mpinnuck/GarageDoorController/Housing/GarageDoorController.FCStd

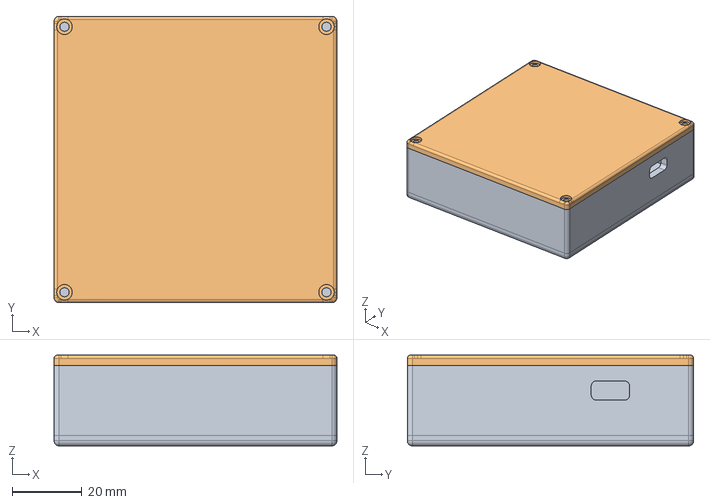
[picture p1: CAD file, 2026-11-12]
Housing/GarageDoorController.FCStd
81.0 x 82.0 x 26.0 mm
Base
Lid
