mpinnuck/GarageDoorController/Housing/stl/Base.stl

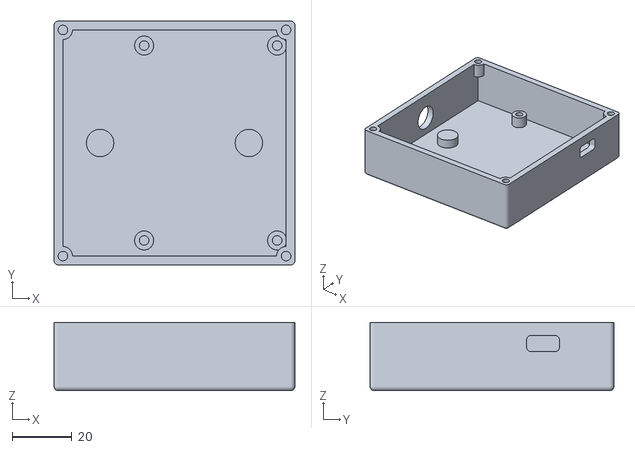
[picture p2: CAD file, 2026-11-12]
Housing/stl/Base.stl
81.0 x 82.0 x 23.0
