mpinnuck/GarageDoorController/Housing/stl/Lid.stl

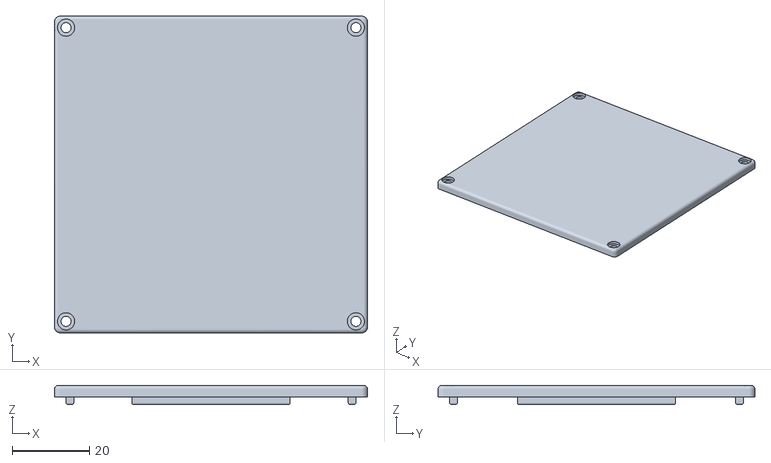
[picture p3: CAD file, 2026-11-12]
Housing/stl/Lid.stl
81.0 x 82.0 x 5.00
