mpinnuck/GarageDoorController/Housing/stl/Washer.stl

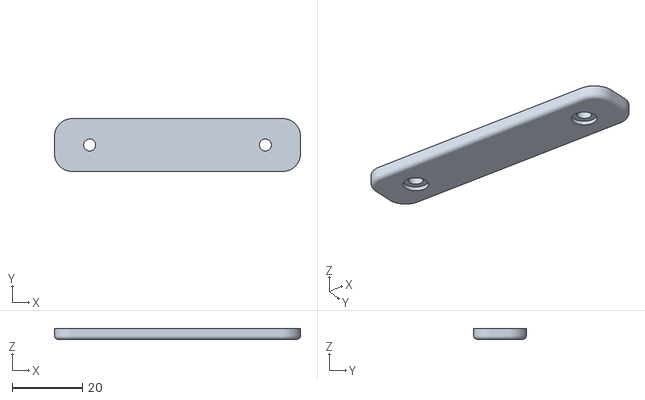
[picture p4: CAD file, 2026-10-28]
Housing/stl/Washer.stl
70.0 x 15.0 x 3.00
