mpinnuck/GarageDoorController/Circuit/GarageDoorController/GarageDoorController.kicad_pcb

## KiCad design Circuit/GarageDoorController/GarageDoorController.kicad_pcb (2026-11-12)

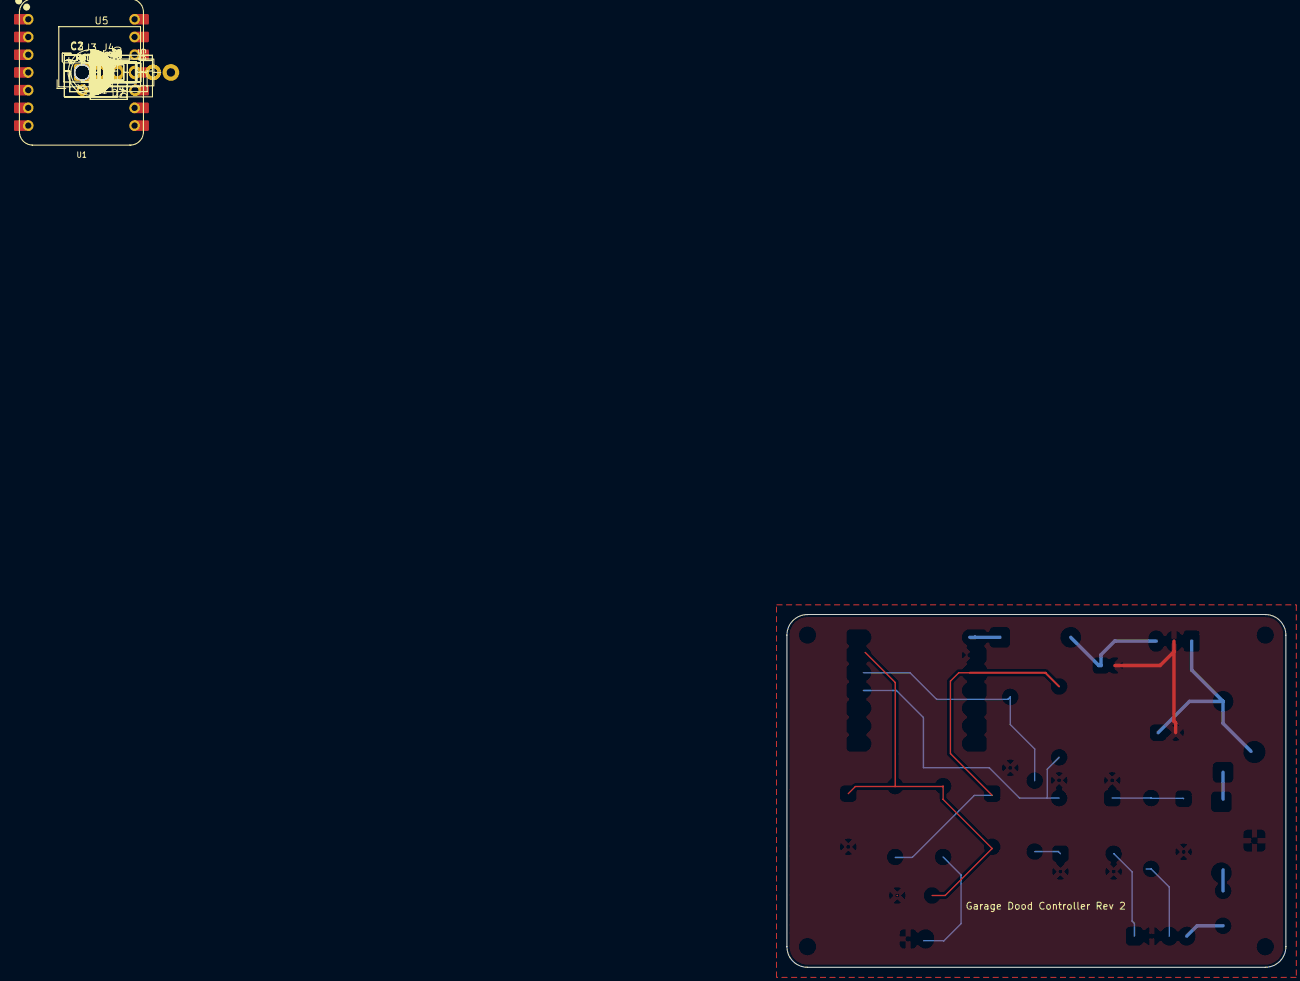
[picture p5: board GarageDoorController.kicad_pcb from above]

Board: 2 copper layers, 71.5 x 50.6 mm, 23 parts (0 on the bottom side), 16 nets.

Parts:
C1: 100nF; C_Disc_D10.0mm_W2.5mm_P5.00mm
C2: 10uF 50V; CP_Radial_D6.3mm_P2.50mm
C3: 22uF 16V; CP_Radial_D5.0mm_P2.00mm
D2, D3, D4: 1N4148; D_DO-35_SOD27_P7.62mm_Horizontal
D5: 1N4007; D_DO-41_SOD81_P10.16mm_Horizontal
D6: P6KE30CA; D_DO-15_P12.70mm_Horizontal
D7: 1N5819; D_DO-41_SOD81_P10.16mm_Horizontal
D8: 1N4740A 10V 1W; D_DO-41_SOD81_P10.16mm_Horizontal
F1: MF-R020 0.2A; C_Disc_D5.0mm_W2.5mm_P5.00mm
J3: JST PH 2-pin; JST_XH_B2B-XH-A_1x02_P2.50mm_Vertical
J4: JST PH 4-pin; JST_XH_B4B-XH-A_1x04_P2.50mm_Vertical
R1, R9: 10k; R_Axial_DIN0207_L6.3mm_D2.5mm_P10.16mm_Horizontal
R6: 1k; R_Axial_DIN0207_L6.3mm_D2.5mm_P10.16mm_Horizontal
R7: 330R; R_Axial_DIN0207_L6.3mm_D2.5mm_P10.16mm_Horizontal
R8: 4k7 1/4W; R_Axial_DIN0207_L6.3mm_D2.5mm_P10.16mm_Horizontal
R10: 100k; R_Axial_DIN0207_L6.3mm_D2.5mm_P10.16mm_Horizontal
U1: XIAO-ESP32-C3-DIP; XIAO-ESP32C3-DIP
U3: TLP222A; DIP-4_W7.62mm
U4: PC817; DIP-4_W7.62mm
U5: R-78E5.0-0.5; Converter_DCDC_RECOM_R-78E-0.5_THT

Connections:
+3V3: D2.1 (K), R1.1, R9.1, U1.12 (VCC_3V3)
/Opener control/LAMP: J4.3, R8.2
/Opener control/OPENER_24V: F1.1, J4.4
/Opener control/PB: J4.1, U3.4
GND: C1.2, C2.2, C3.2, D3.2 (A), D4.2 (A), D6.1 (A1), J3.1, J4.2, R10.2, U1.13 (GND), U3.2, U3.3, U4.2, U4.3, U5.2 (GND)
unnamed: C1.1, D2.2 (A), D3.1 (K), R1.2, R6.2, U1.2 (GPIO3/A1/D1)
unnamed: D4.1 (K), R8.1, U4.1
unnamed: D5.2 (A), F1.2
unnamed: D5.1 (K), D8.1 (K)
unnamed: C2.1, D6.2 (A2), D8.2 (A), U5.1 (IN)
unnamed: C3.1, D7.2 (A), U5.3 (OUT)
unnamed: J3.2, R6.1
unnamed: R7.2, U3.1
OPENER_MOVING: R9.2, U1.4 (GPIO5/A3/D3), U4.4
OPENER_TRIG: R7.1, R10.1, U1.3 (GPIO4/A2/D2)
XIAO_5V: D7.1 (K), U1.14 (VBUS)
