mpinnuck/GarageDoorController/(commit log)

2026-10-26 Claude initial layout
    [GarageDoorController.kicad_pcb, GarageDoorController.kicad_sch, opener-control.kicad_sch]
2026-10-27 Rev 1 PCB: routed board and fab files
    - 2-layer, 71.5 x 50.6 mm, rounded corners, four M2 mounting holes,
    GND pours both layers
    - Opener parts placed and routed: 24 V input chain (J4, F1, D5, D8,
    C2/D6, U5 R-78E, C3/D7 to XIAO 5 V), U3 TLP222A on PB, U4 PC817 on FLASH
    - Power path 0.5 mm; direct F.Cu ground returns U5 to C2/C3
    - DRC: 0 errors, 0 unconnected, 19 cosmetic warnings (DRC.rpt)
    - Gerbers and drill files in gerbers/, zipped for the fab
    - Ignore .DS_Store
    Claude-Session: https://claude.ai/code/session_01BUyReJ4iEoMZE9spF9mEyw
    [GarageDoorController-B_Cu.gbl, GarageDoorController-B_Mask.gbs, GarageDoorController-B_Paste.gbp, GarageDoorController-B_Silkscreen.gbo, GarageDoorController-Edge_Cuts.gm1, GarageDoorController-F_Cu.gtl, GarageDoorController-F_Mask.gts, GarageDoorController-F_Paste.gtp]
2026-10-28 Rev 2 PCB all references to FLASH changed LAMP + Controller housing
    [Base.stl, GarageDoorController.FCStd, GarageDoorController.kicad_pcb, Lid.stl, Washer.stl, opener-control.kicad_sch]
2026-11-12 Rev 2a updated JST footprint from 2 to 2.5mm
    [Base.stl, GarageDoorController.FCStd, GarageDoorController.kicad_pcb, GarageDoorController.kicad_sch, Lid.stl, opener-control.kicad_sch]
2026-11-12 v1.2.0 improved restart safety and loging reject command reasons
    [GarageDoorController.kicad_sch]
